ros-mobile-robots/remo_description/(threads)

Thread 1 (2021-06-08):

3D printed modular frame/chassis

fjp, 2021-06-08:
Include design of modular 3D printed frame/chassis

- Uses [Nvidia Jetbot chassis](https://github.com/NVIDIA-AI-IOT/jetbot) as base

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

- Platform to mount a laser scanner
- Mount for perception system (Raspi cam, OAK-1/D, Intel Realsense, ...)
- Modular top deck for different development boards (single board computers): Rasperry Pi, Jetson Nano
- Fit DG01D-E motor with encoder

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

Closed 2021-06-08.

Thread 2 (2021-10-17):

STL files seem unusable

prgrobots, 2021-10-17:
The STL files wont open in CURA or windows 3D.

After downloading the repo, none of the STLs will open and the file sizes are different than what the github hosted version is?

Is the  the original Fusion 360 file somewhere so I can create the STLs myself?

When I clone with Github Desktop it gives me this error, it appears the  repository is over its data limit

Cloning into 'C:\Users\PC\Documents\GitHub\remo_description'...
remote: Enumerating objects: 196, done.
remote: Counting objects: 100% (196/196), done.
remote: Compressing objects: 100% (134/134), done.
remote: Total 196 (delta 81), reused 147 (delta 51), pack-reused 0
Receiving objects: 100% (196/196), 44.62 KiB | 703.00 KiB/s, done.
Resolving deltas: 100% (81/81), done.
Downloading meshes/components/IMX219.stl (183 KB)
Error downloading object: meshes/components/IMX219.stl (1db7d12): Smudge error: Error downloading meshes/components/IMX219.stl (1db7d1227624a11c30d6b6da4815d4ca69a6699a2323c870b66d54be17c89912): batch response: **This repository is over its data quota. Account responsible for LFS bandwidth should purchase more data packs to restore access.**

Thanks

prgrobots, 2021-10-29:
Thanks Franz,

Working now, looking forward to to getting started!

fjp, 2021-10-31:
Your welcome and thanks for letting me know its working now. I hope the print works out fine but if you encounter any problems feel free to open a new issue :-)

prgrobots, 2021-10-31:
Thanks Franz, its a lovely model

I have modified the Lidar deck to accommodate the A1M8-R6 ( https://www.dfrobot.com/product-1125.html ),  there are a few changes to make before its finished but you are welcome to add it to the repo.

fjp, 2021-10-31:
Thank you @prgrobots.

Awesome, that would be a really useful addition. With it the overall robot becomes even more affordable for others to build. Once you are ready, feel free to open up a PR or you can also share the stl file in a new issue/discussion or reply here.

prgrobots, 2021-11-15:
Hi Franz.

I have attached the alternate deck STL and some pictures of the build.  You will have to excuse my print,  I am using a 0.8mm nozzle for prototyping.

I also trimmed the camera mount (badly with tinkercad,  if only I had the original Fusion files) to print without supports for the Raspberry Pi camera and used a caster in place of the ball roller, I figure it will take the weight better

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
[STLs.zip](https://github.com/ros-mobile-robots/remo_description/files/7538730/STLs.zip)

prgrobots, 2021-11-15:
I did want to ask about the Teensy. The encoders cant be going that fast, would a Seeed Studio Xiao or ESP32 work instead?

fjp, 2021-11-15:
Really nice @prgrobots, this is a great design! Thanks a lot for sharing it :-)

In case you still need the Fusion files I can send them to you by mail, just contact me at ros@fjp.at

Either way, I would be happy to add your final STLs to the repository. Please let me know if you want to create a PR with the final files, or if I should add the ones you shared.

> I did want to ask about the Teensy. The encoders cant be going that fast, would a Seeed Studio Xiao or ESP32 work instead?

The quadrature encoders only give approximately 542 ticks. So these boards should work as well but I haven't tested it. However, would be interesting to know if they are also usable.

Closed 2021-10-31.

Thread 3 (2022-11-15):

Old parts on BOM?

parkournerd, 2022-11-15:
Could you help me read the BOM? (https://ros-mobile-robots.com/components/)

I'm looking to build the REMO Robot for a demo and I see there's a Grove stepper driver, Grove I2C splitter, I/O expander, front ultrasonic, etc that are not in the assembly video or gumroad assembly.

Thank you!

parkournerd, 2022-11-15:
It looks like there are DiffBot parts in there.

fjp, 2022-11-15:
Thanks for pointing this out @parkournerd, I'll try to clarify this in the documentation.

You are correct that the Grove stepper driver, Grove I2C hub and ultrasonic sensor are **not** used for REMO. For REMO the Adafruit DC Motor (+ Stepper) FeatherWing is used. You could use the Grove I2C hub as shown in the electronics schematic: https://ros-mobile-robots.com/hardware_setup/electronics/ to connect additional I2C devices, but I currently have the I2C of the feather wing motor driver directly connected to the teensy mcu (without using the I2C hub).

I am not entirely sure what you mean by the I/O expander but in case you refer to the [extension cable](https://ros-mobile-robots.com/components/#breadboard-and-gpio-extension-cable) then it is also optional and might be only useful for testing purposes.

parkournerd, 2022-11-16:
Thanks for getting back so quickly and in detail.

Where is the best place to ask small questions by the way? I'm going to build one, so they will likely come up. For instance, I saw you used a teensy for its encoder counter, but I'm thinking you could just do that the SBC itself since that should only require 144hz polling.

fjp, 2022-11-16:
> Where is the best place to ask small questions by the way? I'm going to build one, so they will likely come up.

For code related questions I'd suggest to first check the [discussions in the diffbot code repo](https://github.com/ros-mobile-robots/diffbot/discussions) and if there is nothing that helps, feel free to open a new question. Creating an [issue](https://github.com/ros-mobile-robots/diffbot/issues) is also fine.

> For instance, I saw you used a teensy for its encoder counter, but I'm thinking you could just do that the SBC itself since that should only require 144hz polling.

That is also something I wanted to do in the first place, but I was warned that some ticks might be missed by the Raspberry Pi SBC. May I ask how do you get to the 144 Hz polling value? And do you know which maximum frequency the SBC is capable of polling over its GPIO pins?

I've never actually tested a direct connection between the encoders and the SBC myself but there is an open issue about it: https://github.com/ros-mobile-robots/diffbot/issues/4#issuecomment-782881748. In the comment it is mentioned that with a device tree overlay for a rotary encoder no ticks were missed (one motor/encoder). There seems to be already a [rotary-encoder overlay](https://github.com/raspberrypi/firmware/blob/master/boot/overlays/README#L3264) inside the official raspbian image but I am not sure about the ubuntu mate image, then you probably have to compile it as mentioned in the comment.

parkournerd, 2022-11-16:
Sweet, I'll go there first next time. This was my calculation assuming you don't have erroneous reads or noise:
(2 pulses per rotation) x (48 motor ratio) x (90 rpm) / (60s/min) = 144 pulses/s per channel

parkournerd, 2022-11-16:
We'd have to just test it because it all depends on the scheduling

fjp, 2022-11-16:
I'd expect a higher frequency because these quadrature encoders of the DG01D-E motors seem to provide roughly 542 counts (aka ticks) per one full rotation of the wheel (not measured at the motor shaft). You can find some more infos about the encoders, including the pole count of 6, on this documentation page https://ros-mobile-robots.com/DG01D-E-motor-with-encoder/.

Also I am not entirely sure if the gear ratio (1:48) is correctly specified in the data sheet. But it is probably close to this ratio.

I agree it would be interesting to test if the SBC can handle all the ticks.

parkournerd, 2022-11-17:
I calculated assuming single pole pair oops: (144 pulses / s) x (3 pole pairs) = 432 pulses / s per channel
Your calculation: (1344PPR) / (2 channels) / (1.5 rps) = 448 pulses / s per channel
So, the theoretical and empirical line up ... "enough" lol

---

Thanks!

parkournerd, 2022-12-07:
**Could you let me know where the 25mm screws / inserts go?** I reviewed the assembly video and only saw short screws.

Also, might want to clarify:
- that the wheels come from the kit
- easy specifications in case people can't source the exact same materials (i.e. any smooth, durable 3/4" for the caster)

Thread 4 (2024-02-03):

Motor wiring

Kindlabs, 2024-02-03:
sparkfun’s hobby motor’s wire color is backwards from what you show in wiring diagram. This took me way too long to figure out but hopefully I can help others. Theirs has blue on top and brown on bottom

fjp, 2024-06-02:
Hi @Kindlabs thanks for the hint. Can you please point me to their wiring diagram and the one in the ros-mobile-robots documentation that has an issue? The one I found on [their website](https://www.sparkfun.com/products/16413) is this:

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

This seems to show the same (correct) wiring as the one in Remo diagrams:

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
[https://ros-mobile-robots.com/hardware_setup/electronics/](https://ros-mobile-robots.com/hardware_setup/electronics/)

and the one shown [here](https://ros-mobile-robots.com/DG01D-E-motor-with-encoder/#terminal-pin-layout):

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

I agree the following text is a bit misleading:

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

Would be great if you could clarify the confusing part, so that we can update it in the documentation. Feel free to open a PR yourself as well.

fjp, 2024-06-02:
Would it help if the text was changed to:

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

Or is there some image that needs to be fixed? I think with the original connector, which can only be plugged in one direction, the colors should match to what is shown in the wiring diagram:

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
[https://ros-mobile-robots.com/hardware_setup/electronics/](https://ros-mobile-robots.com/hardware_setup/electronics/)

Routing the Brown and Red cables of the plugged in connector cable to the motor driver and the rest of it (Orange, Yellow, Green, Blue pins) to the micro controller (teensy) for reading the encoder values has worked so far for me.
