ros-mobile-robots/remo_description/config/remo/front_wheel.yaml

mass: 0.032        # Wheel mass in Kg (32 g)
radius: 0.0331    # Wheel radius in m
length: 0.025     # Wheel length in m, considering is as a cylinder
mesh: '../components/wheel.stl'          # Name of the mesh files. Leave it empty ('') to have a red wheel
#mesh: ''
scale: ''
x_offset: 0.034
y_offset: 0.017
z_offset: -0.0336
