ros-mobile-robots/remo_description/config/remo/motor.yaml

mass: 0.041        # Motor mass in Kg (41 g)
x_size: 0.07       # Motor dimension in x axis
y_size: 0.0225     # Motor dimension in y axis
z_size: 0.0188     # Motor dimension in z axis
mesh: 'DG01D-E_motor_w_encoder.stl'  # Name of the mesh files. Leave it empty ('') to have a red wheel
#mesh: ''
scale: '0.001 0.001 0.001'
x_offset: 0.058
y_offset: -0.008
z_offset: -0.0336
color: Gazebo/SkyBlue
