ros-mobile-robots/remo_description/(commit log)

2025-05-07 Initial public version: placeholder STLs, asset downloader added
    [addon_macro.urdf.xacro, common_macros.urdf.xacro, common_sensors.xacro, motor.yaml, remo.urdf.xacro, remo_base_macro.urdf.xacro, remo_caster_macro.urdf.xacro, robot.gazebo.xacro]
2026-10-14 Install the model files, so the package works from an install space (#1)
    * Install the model files, so the package works from an install space
    catkin's install space had only package.xml and the CMake files:
    config, launch, meshes, rviz and urdf weren't installed. diffbot's
    simulation test (ros-mobile-robots/diffbot#112) builds this package in
    industrial_ci, which always uses an install space, and xacro then can't
    find urdf/remo.urdf.xacro.
    * Explain the install rule's comment more clearly
    "industrial_ci tests from one" left open what "one" is. Say what
    the install space is, what goes missing without the rule and who
    builds from it.
2026-10-19 Measured wheel radius and separation (#3)
    Measured on Remo: wheel diameters 65.5 and 66.5 mm, so a radius of 0.0330 m (was 0.0331), and a wheel separation of 0.144 m from the middle of one tire to the middle of the other (was 0.139 m). y_offset becomes 0.0195 m, so the wheel joints are 0.144 m apart. diffbot's controller configuration uses the same values (ros-mobile-robots/diffbot#119).
2026-10-20 Gazebo: sphere collision and damped contacts for the drive wheels (#2)
    Gives Remo's drive wheels the same contact model as DiffBot's since diffbot#120, with contact settings that work with it. The casters are unchanged.
    - urdf/include/common_macros.urdf.xacro: the drive wheels' collision is a sphere with the wheel radius instead of a cylinder, so it touches the ground at one point in the wheel's center plane. With cylinders and minDepth 0, Remo turned 1.28 of 1.50 rad, 0.144 / 0.169 m, the outer-edge ratio. The visual and the cylinder inertia are unchanged.
    - urdf/include/robot.gazebo.xacro, the drive wheels: friction 1 (was 200), kp 1e7 (1e12), kd 1 (0), minDepth 0 (0.01), no fdir1 (0 0 1)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
2026-10-25 Package: version 1.0.0 and a changelog (#6)
    The package gets its first version number, 1.0.0, and a changelog, so that the diffbot repository can pin a version of Remo's model instead of a commit (ros-mobile-robots/diffbot#129). 1.0.0 is `main` as it is: the model doesn't change.
    - `package.xml`: version 0.0.0 → 1.0.0.
    - `CHANGELOG.rst`: the changes so far, in the format of [REP 132](https://www.ros.org/reps/rep-0132.html), which ROS tools such as `catkin_generate_changelog` and bloom read.
    - CONTRIBUTING.md, AGENTS.md and the pull request template:
    - the diffbot repository's dev container clones the version selected in `diffbot_dev.repos`, so you check out your branch first;
    - if you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
2026-10-26 Frames: base_link and base_footprint at the axle's midpoint (#5)
    `base_link` is now directly above the midpoint between the drive wheels, at the same height as before, with `base_footprint` on the ground below it. The base plate's geometry and mass, and every part attached to it, hang off a new `chassis_link`, 36 mm behind `base_link`.
    **Why:** `diff_drive_controller` computes the odometry for the axle's midpoint and publishes it as `base_footprint`. But in the URDF, `base_footprint` was on the ground under the center of the base plate, and that center is 36 mm behind the axle. The controller's odometry and the URDF used different reference points, so TF placed the chassis and the sensors i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
2026-11-05 IMU: imu_link for the BNO055 with a Gazebo IMU sensor (#10)
    ## What and why
    Remo's model gets an IMU: `imu_link` for the Bosch BNO055 board on `chassis_link`, with a Gazebo IMU sensor, so that the simulation has the same IMU as the robot. diffbot's IMU series (ros-mobile-robots/diffbot#21) reads the BNO055 on the Teensy, and an EKF fuses its yaw rate with the wheel odometry, in the simulation as on the robot.
    - **`urdf/include/common_sensors.xacro`:** the `imu_sensor` macro, with the configured mass and inertia, a placeholder collision box, the mesh as its visual, and gazebo_plugins' ROS 1 IMU plugin. It publishes `/diffbot/imu/gazebo` at 50 Hz, the firmware's rate, in `imu_link`. diffbot'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
2026-11-05 IMU and Teensy: on the breadboard as on Remo (#11)
    Version 2.1.0 placed the IMU from a first measurement with a ruler. A look at Remo showed where both boards on the breadboard really sit:
    - **IMU:** its center lies at the breadboard's front-to-back midpoint, and its header pins sit in the breadboard's holes. The board's left edge is then about flush with the breadboard's left edge, 0.5 mm beyond it in the meshes. `imu_xyz` changes from `-0.034 0.025 0.013` to `-0.0401 0.0234 0.013`, 7.6 cm behind the wheel axle and 2.34 cm left of the center line. The orientation stays as measured in 2.1.0.
    - **Teensy:** its pins go into the breadboard's holes. The Teensy's two pin rows ar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
2026-11-06 IMU: the Gazebo plugin library as the xacro argument imu_plugin (#15)
    **Before:** Remo's IMU macro names gazebo_plugins' `libgazebo_ros_imu_sensor.so` in the IMU sensor's Gazebo `<plugin>` element ([`common_sensors.xacro` at 2.2.0](https://github.com/ros-mobile-robots/remo_description/blob/2.2.0/urdf/include/common_sensors.xacro#L249)). That plugin calls `ros::spinOnce()` in Gazebo's physics thread. In the diffbot repository's simulation, that call sometimes runs the controller manager's service to load or switch a controller in the physics thread. The service waits for the same thread, and Gazebo's clock stops for good (ros-mobile-robots/diffbot#185).
    **With this pull requ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
2026-11-06 Revert: the Gazebo plugin library as the xacro argument imu_plugin (#16)
    #15 merged before #12, #13 and #14, which were planned to merge first. This reverts #15's squash commit, so `main` is the 2.2.0 model again and the open pull requests keep their versions: #12 2.2.1, #13 2.3.0, #14 2.4.0. #15's change, the xacro argument `imu_plugin`, comes back after them as 2.5.0.
    ## How it was tested
    The reverted files (`urdf/remo.urdf.xacro`, `urdf/include/common_sensors.xacro`, `package.xml`, `CHANGELOG.rst`) are identical to the 2.2.0 tag.
    ## Documentation
    None needed: nothing user-visible changes compared with 2.2.0.
    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
2026-11-06 Wheels: the visual gets the wheel's mesh once (#12)
    Both conditions in the wheel macro of `urdf/include/common_macros.urdf.xacro` tested for an empty scale. So a wheel without a scale, Remo's default, got its mesh twice in its visual, the second time with `scale=""`. The second condition is now `!= ''`, as in the motor macro. That also repairs wheels with an explicit scale: both old conditions were false for them, so their visual had no mesh at all.
    The model is the same, so this is version `2.2.1`, the third number ([CONTRIBUTING](https://github.com/ros-mobile-robots/remo_description/blob/main/CONTRIBUTING.md)). The Insiders repository gets the same fix as its own `2.2.1`.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
2026-11-06 Model: colours like the real parts (#13)
    Remo's parts get the colours of the real parts, in RViz and in Gazebo. The boards were a see-through, glowing green in Gazebo, and the printed parts grey.
    - **Each part's colour is one `rgba` value in its config file** (`config/remo/*.yaml`), chosen from photos of the real parts:
    | Parts | Colour |
    |---|---|
    | Printed parts (chassis, decks, mounts, caster housing) | black filament, as dark grey `0.12 0.12 0.12` so the shapes keep some shading |
    | Wheels | black, like the rubber tyres. The real rims are yellow, see below |
    | DG01D-E motors | light blue gearboxes |
    | Raspberry Pi 4, Teensy 4.0, Raspberry Pi camera | green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
2026-11-06 IMU: mass 3 g, the BNO055 board as weighed (#14)
    `imu_link` gets the mass of the real BNO055 board: 3 g, weighed with its header pins. The model gave it 5 g. Its box inertia follows from the mass, so it shrinks with it. Gazebo merges `imu_link` and the other parts on fixed joints into one body, `base_footprint`. With the Raspberry Pi deck and camera, it has 1.078 kg instead of 1.080 kg.
    A changed mass is a second-number version, `2.4.0` ([CONTRIBUTING](https://github.com/ros-mobile-robots/remo_description/blob/main/CONTRIBUTING.md)). It follows #12 (`2.2.1`) and #13 (`2.3.0`), which merge first. Both change `package.xml` and `CHANGELOG.rst` too. After their merge, this bran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
2026-11-06 IMU: the Gazebo plugin library as the xacro argument imu_plugin (#17)
    This brings back #15, which merged before #12, #13 and #14 and was reverted in #16. The commit is the same one Codex reviewed for #15, `230be89`, version 2.5.0.
    **Before:** Remo's IMU macro names gazebo_plugins' `libgazebo_ros_imu_sensor.so` in the IMU sensor's Gazebo `<plugin>` element ([`common_sensors.xacro` at 2.2.0](https://github.com/ros-mobile-robots/remo_description/blob/2.2.0/urdf/include/common_sensors.xacro#L249)). That plugin calls `ros::spinOnce()` in Gazebo's physics thread. In the diffbot repository's simulation, that call sometimes runs the controller manager's service to load or switch a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
2026-11-09 Jetson deck: Teensy and IMU move with the breadboard
    The property breadboard_x gives the breadboard's position on
    chassis_link for the chosen sbc_type: -0.04 m with the Raspberry Pi
    deck and -0.05 m with the Jetson Nano deck. breadboard_joint,
    mcu_joint and the default of imu_xyz follow it, so the Teensy's and
    the IMU's header pins sit in the breadboard's holes with either deck.
    imu_xyz stays a position on chassis_link. Version 2.7.0.
